profdc9/QRPAmplifier/README.md

This is a layout of the WA2EBY amplifier, improved with an added overcurrent circuit protection for the PA transistors.  It is licensed under CC-BY-SA 4.0 by Daniel Marks KW4TI
