profdc9/QRPAmplifier/BiggerPA/PA-board.png

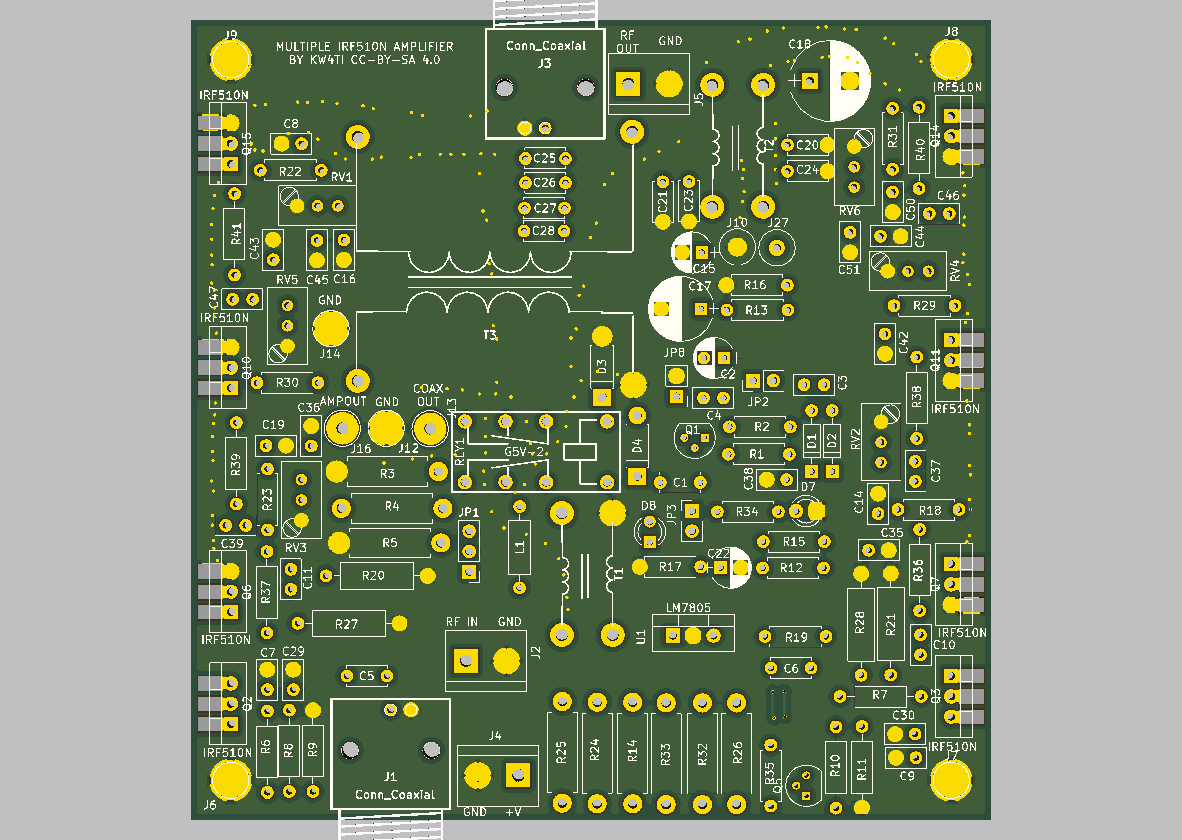
BiggerPA/PA-board.png
