profdc9/QRPAmplifier/Filter/Filter.png

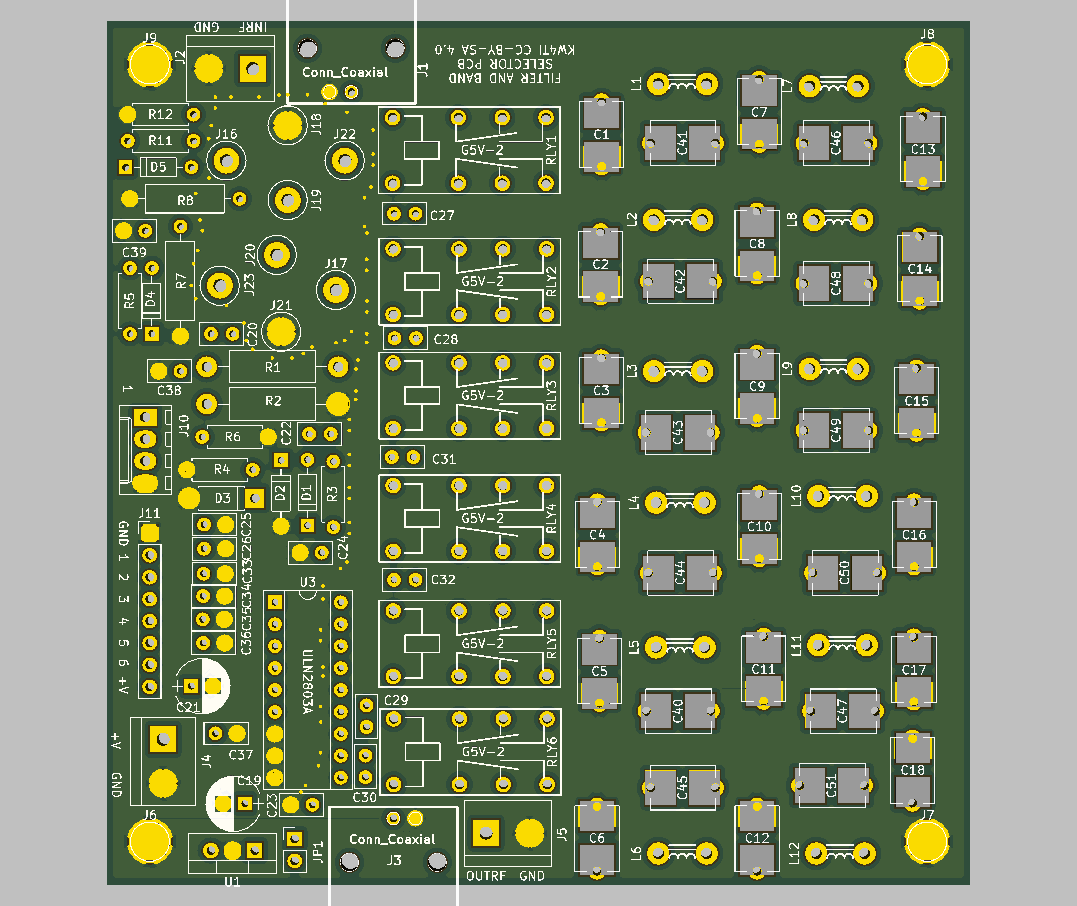
Filter/Filter.png
