profdc9/QRPAmplifier/PA/PA-board.png

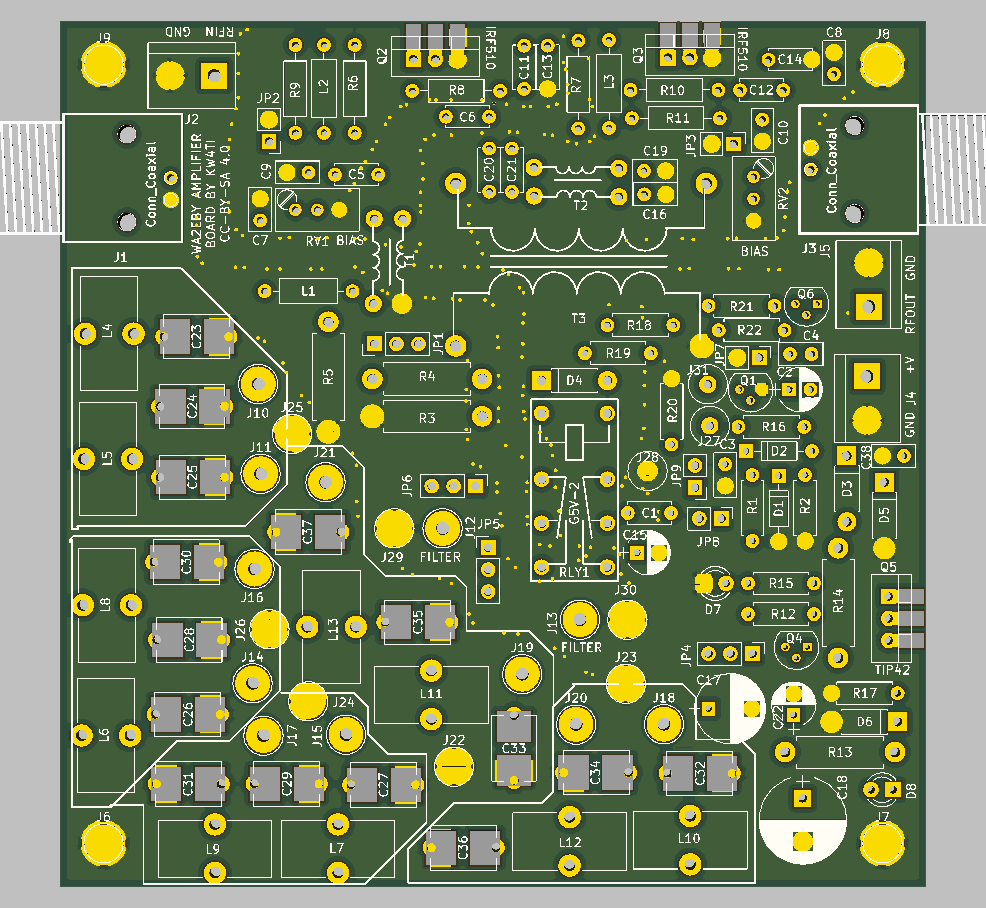
PA/PA-board.png
