profdc9/QRPAmplifier/Filter/Filter-schematic.pdf

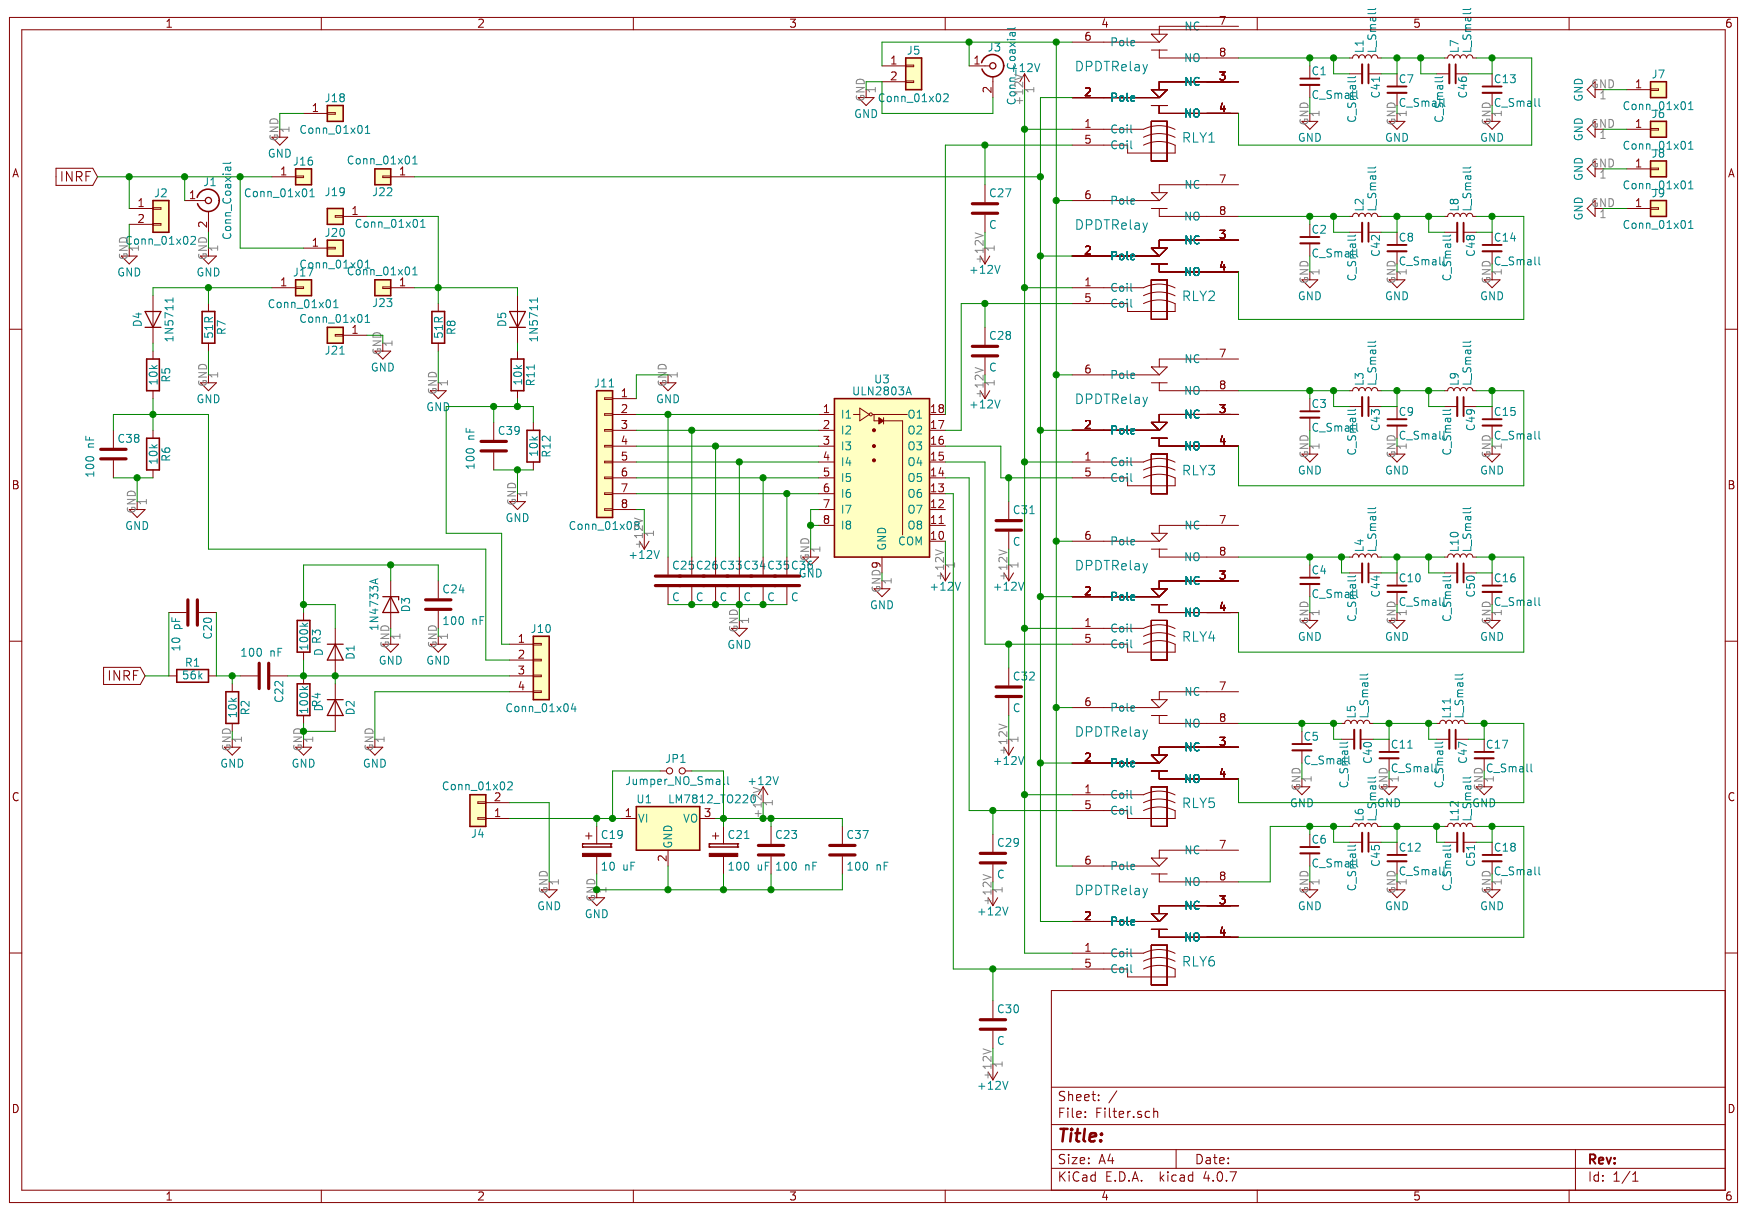
[picture p4: page 1]
