profdc9/QRPAmplifier/BiggerPA/PA-schematic.pdf

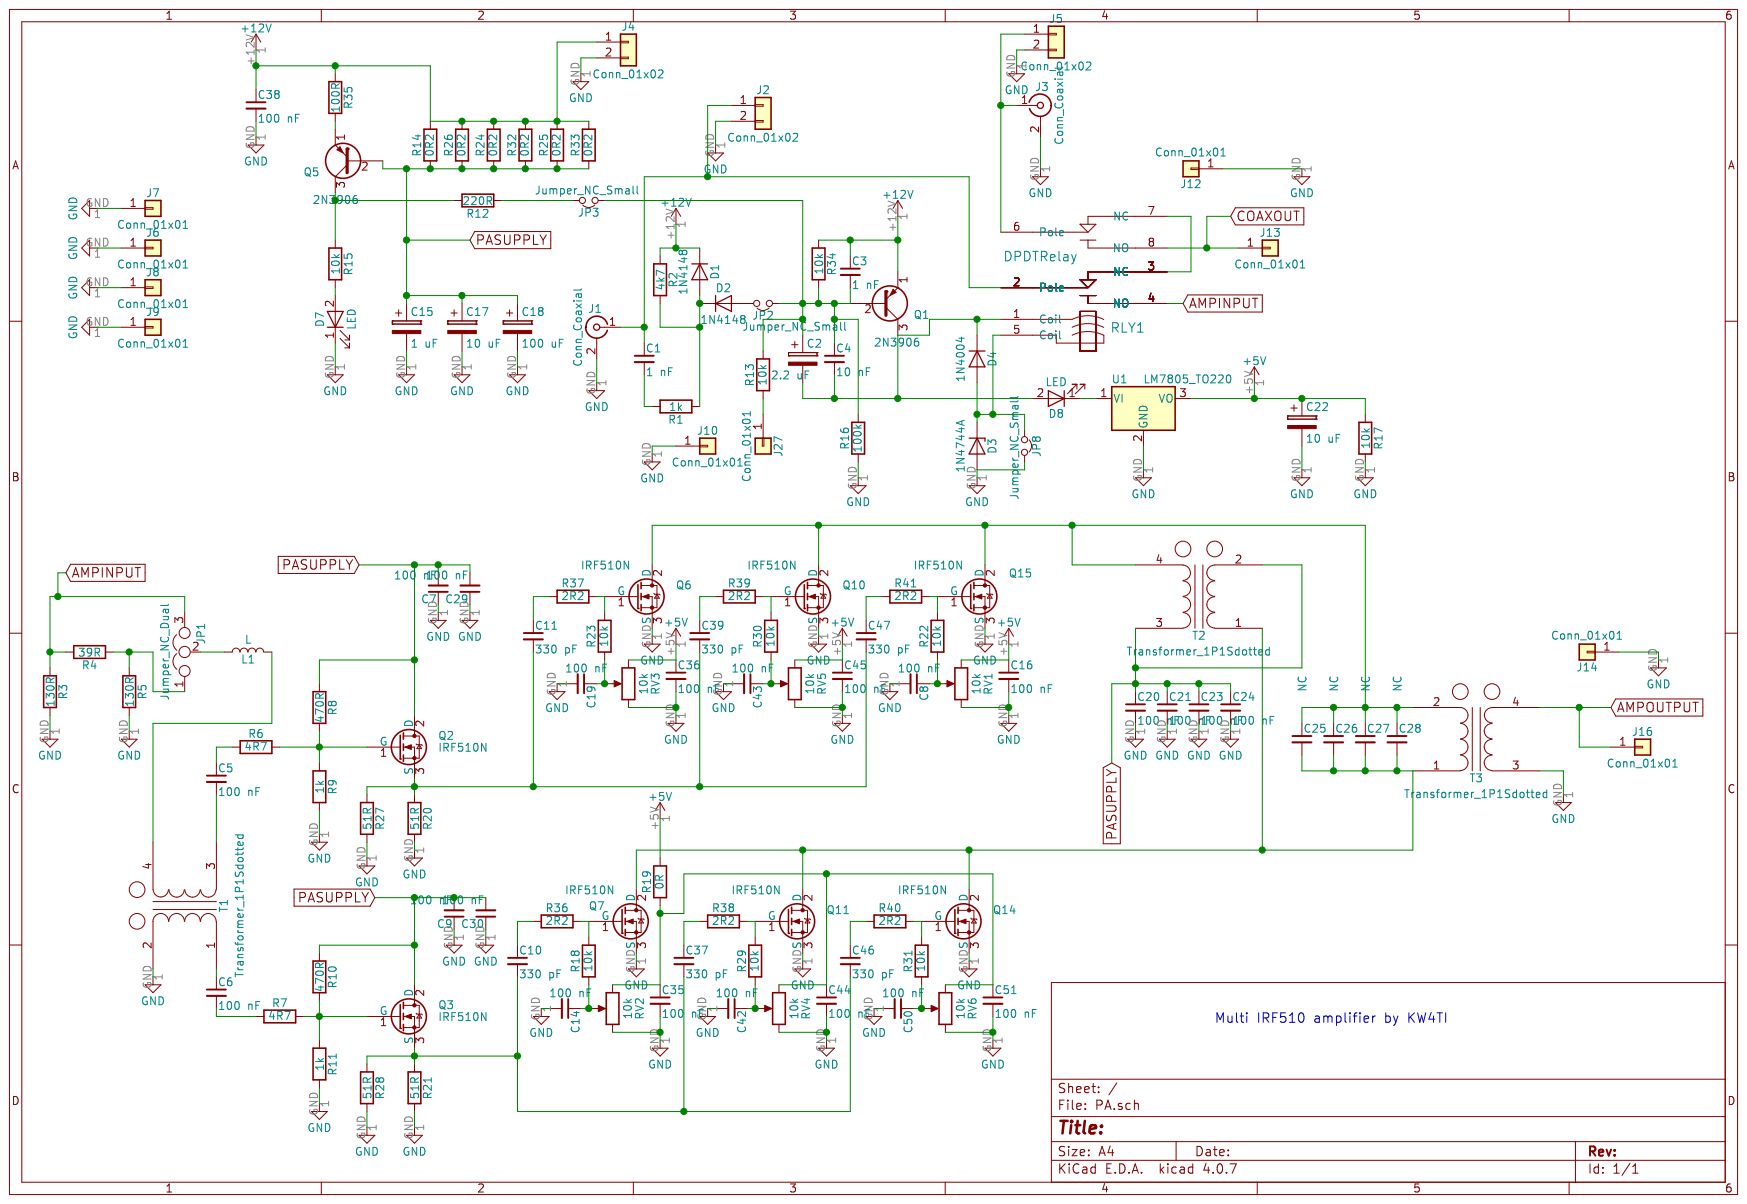
[picture p5: page 1]
