profdc9/QRPAmplifier/PA/PA-schematic.pdf

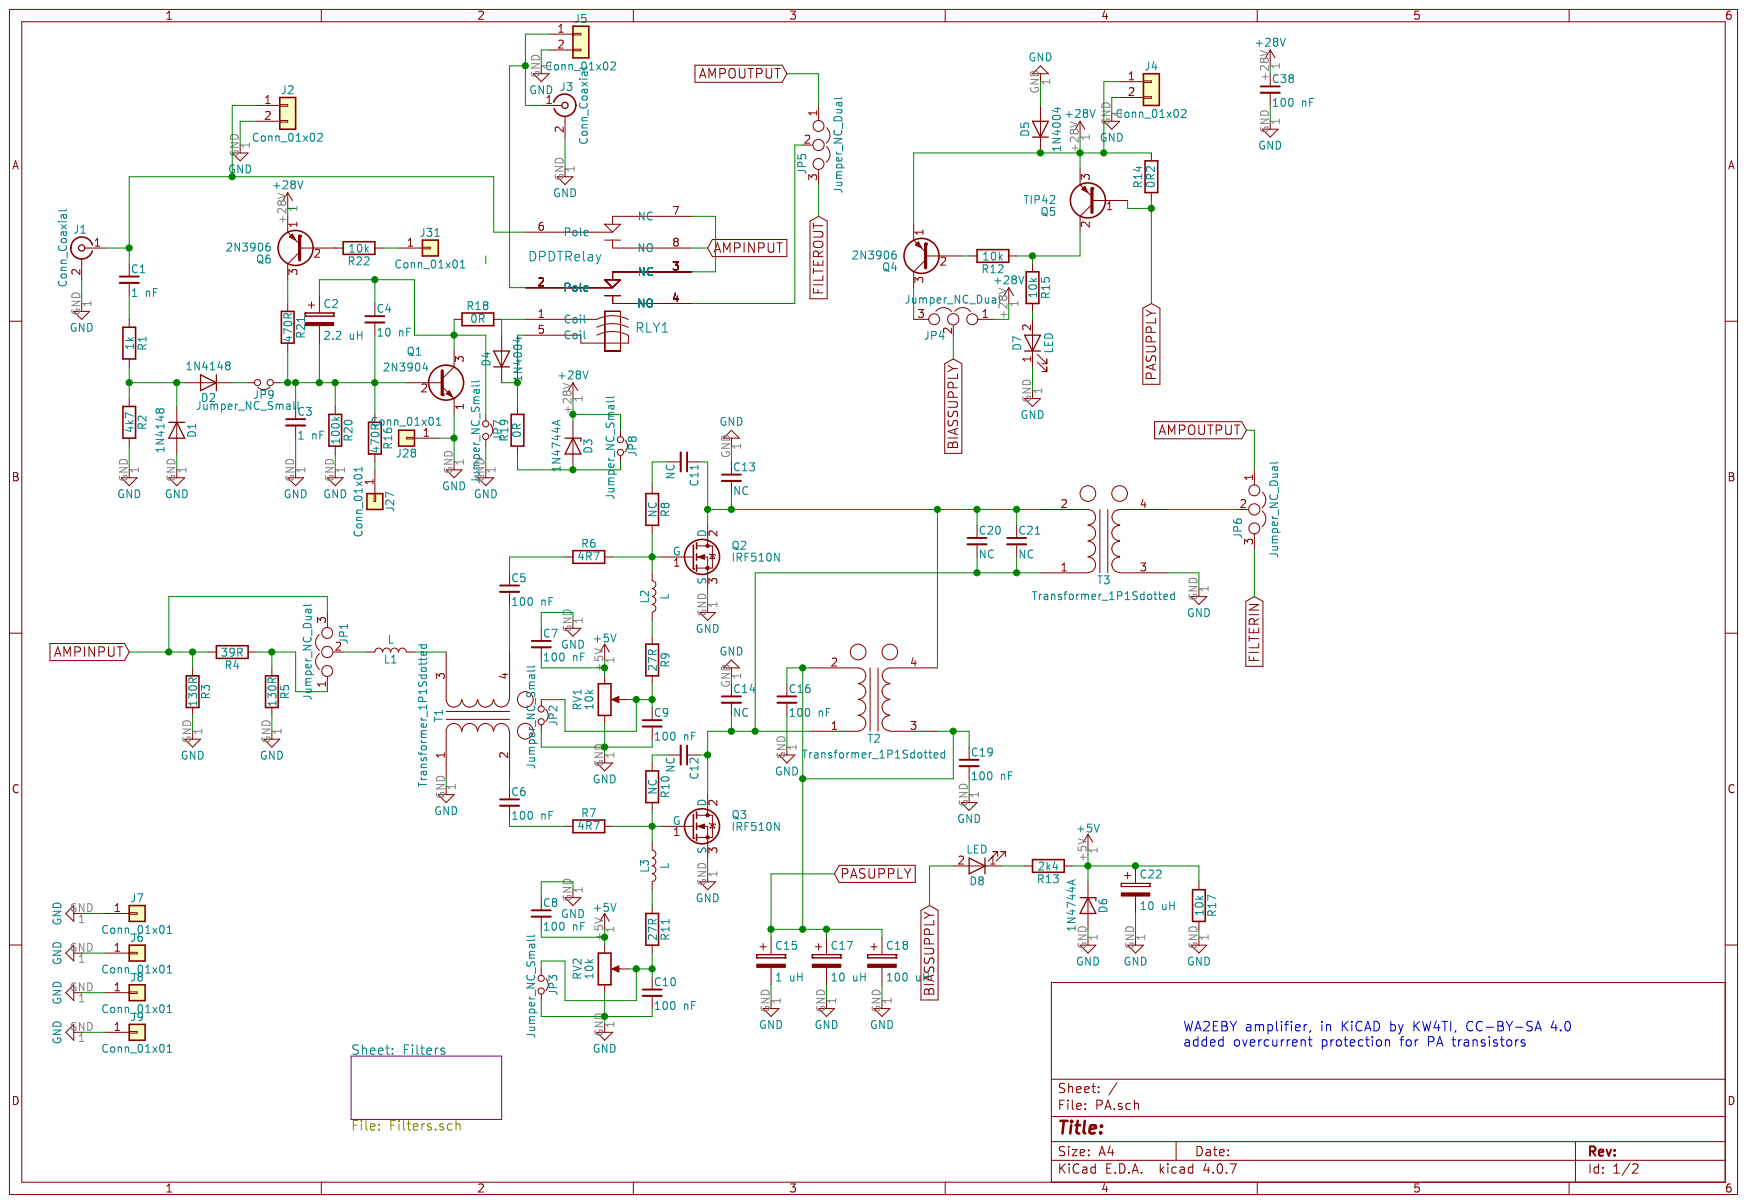
[picture p6: page 1]

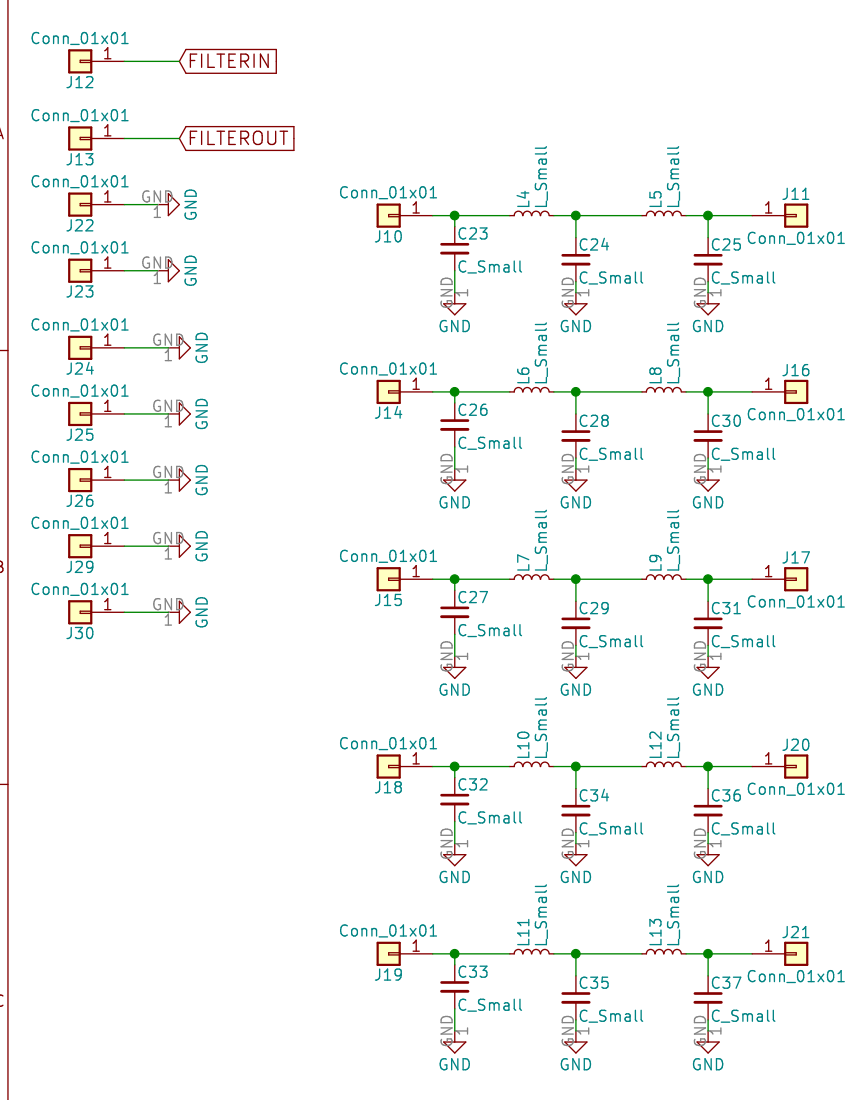
[picture p7: page 2]
