profdc9/QRPAmplifier/BiggerPA/PA.kicad_pcb

## KiCad design BiggerPA/PA.kicad_pcb (2020-04-29)

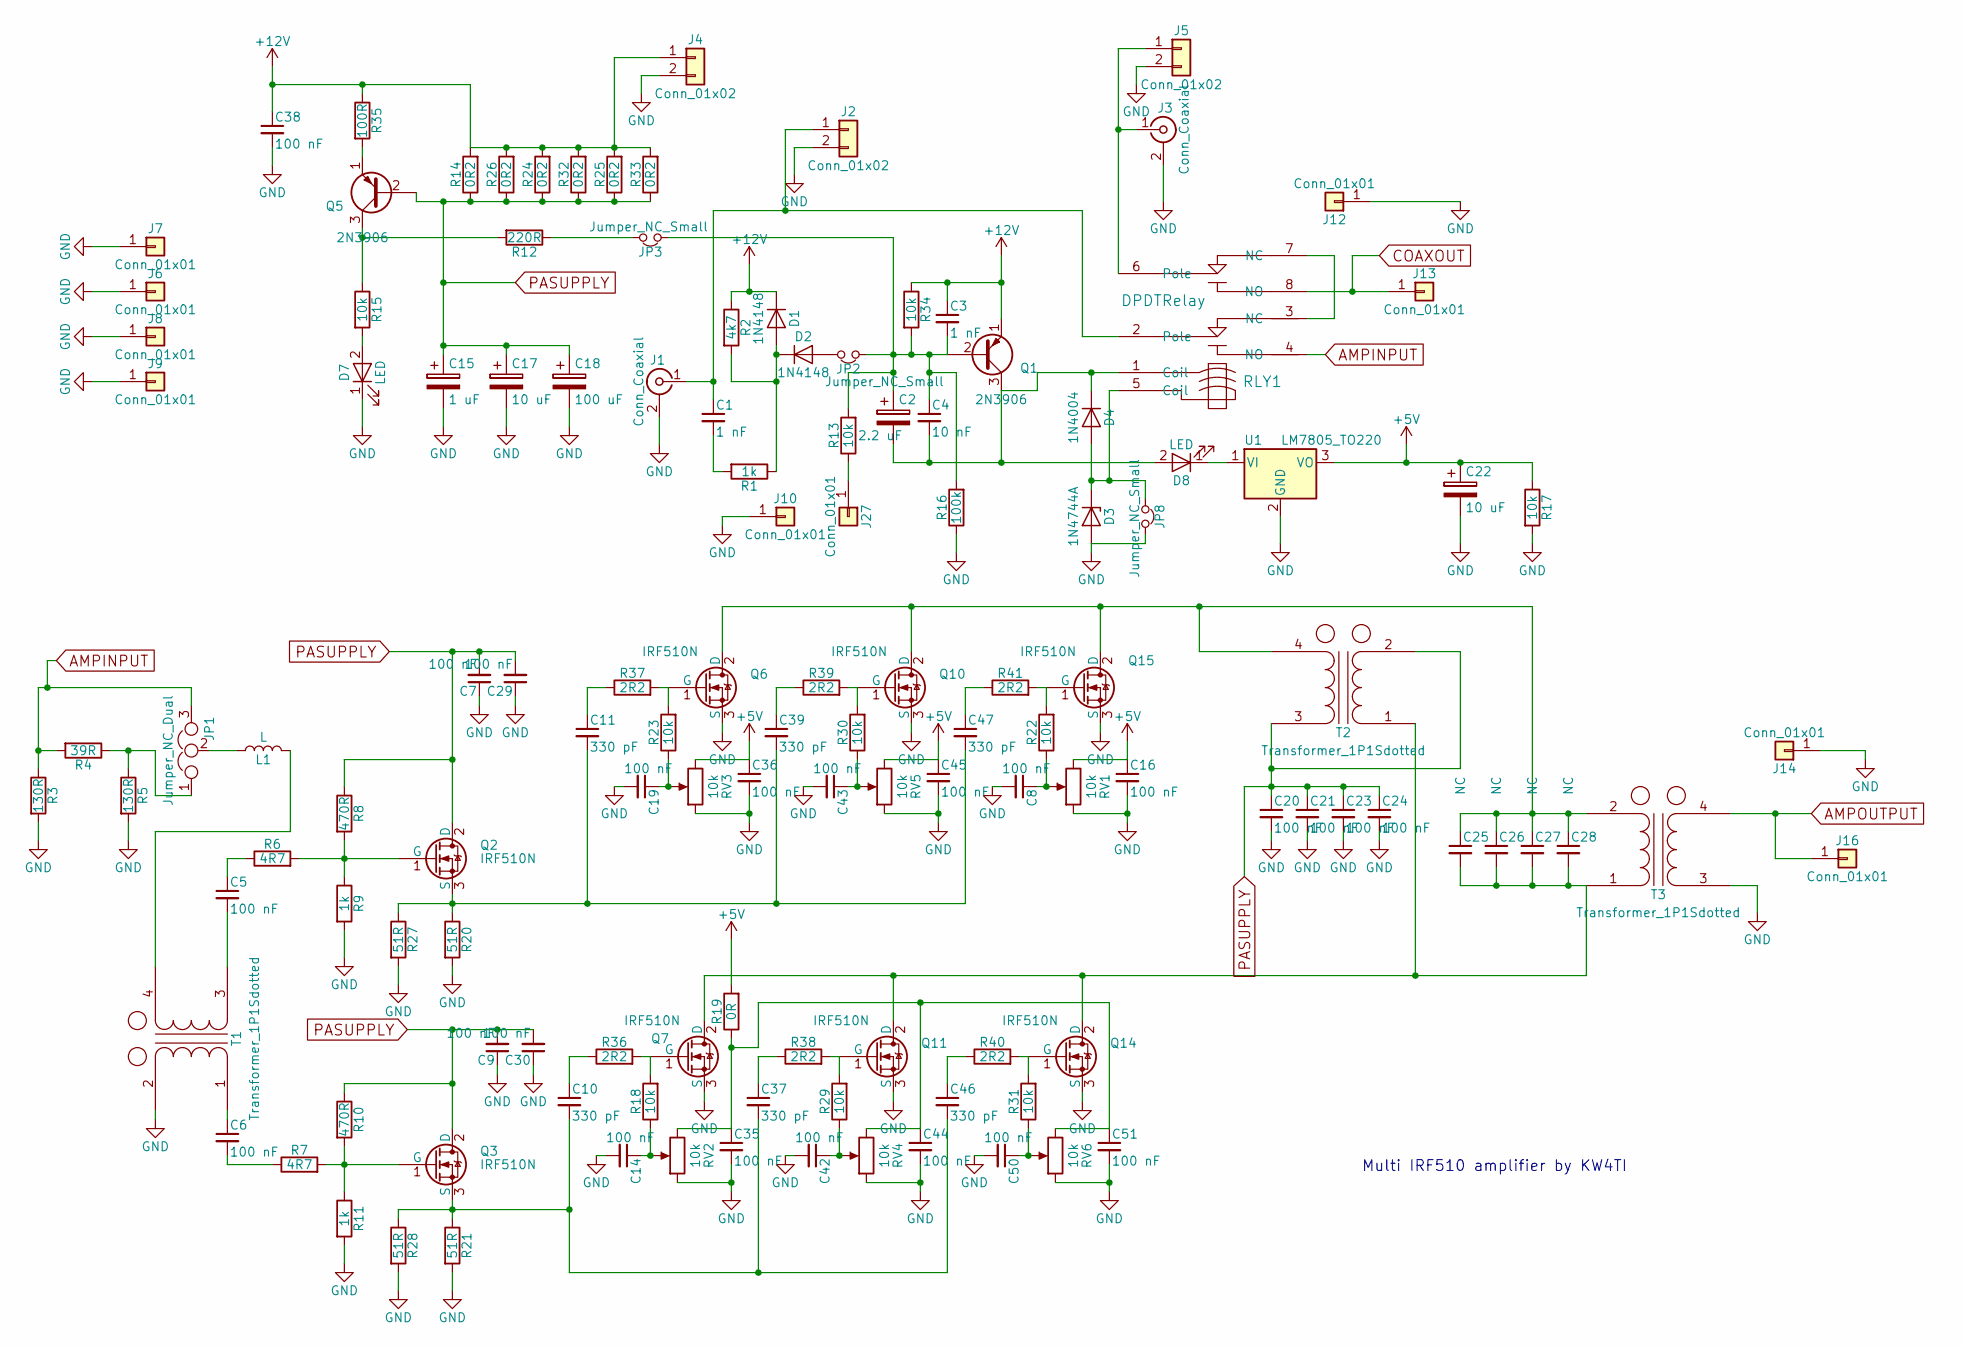
[picture p8: schematic PA.sch]

Parts:
C1: 1 nF; C_Disc_D5.0mm_W2.5mm_P5.00mm
C2: 2.2 uF; CP_Radial_D5.0mm_P2.50mm
C3: 1 nF; C_Disc_D5.0mm_W2.5mm_P2.50mm
C4: 10 nF; C_Disc_D5.0mm_W2.5mm_P2.50mm
C5, C6, C20, C21, C23, C24: 100 nF; C_Disc_D5.0mm_W2.5mm_P5.00mm
C7, C8, C9, C14, C16, C19, C29, C30, C35, C36, C38, C42, C43, C44, C45, C50, C51: 100 nF; C_Disc_D5.0mm_W2.5mm_P2.50mm
C10, C11, C37, C39, C46, C47: 330 pF; C_Disc_D5.0mm_W2.5mm_P2.50mm
C15: 1 uF; CP_Radial_D5.0mm_P2.50mm
C17: 10 uF; CP_Radial_D8.0mm_P5.00mm
C18: 100 uF; CP_Radial_D10.0mm_P5.00mm
C22: 10 uF; CP_Radial_D5.0mm_P2.50mm
C25, C26, C27, C28: NC; C_Disc_D5.0mm_W2.5mm_P5.00mm
D1, D2: 1N4148; D_DO-35_SOD27_P7.62mm_Horizontal
D3: 1N4744A; D_DO-41_SOD81_P7.62mm_Horizontal
D4: 1N4004; D_DO-41_SOD81_P7.62mm_Horizontal
D7, D8: LED; LED_D3.0mm
J1, J3: Conn_Coaxial; bnc_90_1-1337543-0
J2, J4, J5: Conn_01x02; TerminalBlock_bornier-2_P5.08mm
J6, J7, J8, J9, J10, J12, J13, J14, J16, J27: Conn_01x01; 1pin
JP1: Jumper_NC_Dual; Pin_Header_Straight_1x03_Pitch2.54mm
JP2, JP3, JP8: Jumper_NC_Small; Pin_Header_Straight_1x02_Pitch2.54mm
L1: L; L_Axial_L6.6mm_D2.7mm_P10.16mm_Horizontal_Vishay_IM-2
Q1, Q5: 2N3906; TO-92_Molded_Narrow
Q2, Q3, Q6, Q7, Q10, Q11, Q14, Q15: IRF510N; TO-220-3_Vertical_WithPads
R1: 1k; R_Axial_DIN0207_L6.3mm_D2.5mm_P7.62mm_Horizontal
R2: 4k7; R_Axial_DIN0207_L6.3mm_D2.5mm_P7.62mm_Horizontal
R3, R5: 130R; R_Axial_DIN0411_L9.9mm_D3.6mm_P12.70mm_Horizontal
R4: 39R; R_Axial_DIN0411_L9.9mm_D3.6mm_P12.70mm_Horizontal
R6, R7: 4R7; R_Axial_DIN0207_L6.3mm_D2.5mm_P10.16mm_Horizontal
R8, R10: 470R; R_Axial_DIN0207_L6.3mm_D2.5mm_P10.16mm_Horizontal
R9, R11: 1k; R_Axial_DIN0207_L6.3mm_D2.5mm_P10.16mm_Horizontal
R12: 220R; R_Axial_DIN0207_L6.3mm_D2.5mm_P7.62mm_Horizontal
R13, R15, R17, R18, R22, R23, R29, R30, R31, R34: 10k; R_Axial_DIN0207_L6.3mm_D2.5mm_P7.62mm_Horizontal
R14, R24, R25, R26, R32, R33: 0R2; R_Axial_DIN0411_L9.9mm_D3.6mm_P12.70mm_Horizontal
R16: 100k; R_Axial_DIN0207_L6.3mm_D2.5mm_P7.62mm_Horizontal
R19: 0R; R_Axial_DIN0207_L6.3mm_D2.5mm_P7.62mm_Horizontal
R20, R21, R27, R28: 51R; R_Axial_DIN0309_L9.0mm_D3.2mm_P12.70mm_Horizontal
R35: 100R; R_Axial_DIN0207_L6.3mm_D2.5mm_P7.62mm_Horizontal
R36, R37, R38, R39, R40, R41: 2R2; R_Axial_DIN0207_L6.3mm_D2.5mm_P10.16mm_Horizontal
RLY1: DPDTRelay; G2VRelay
RV1, RV2, RV3, RV4, RV5, RV6: 10k; Potentiometer_Trimmer_Bourns_3296W
T1, T2: Transformer_1P1Sdotted; GenericCMCL3
T3: Transformer_1P1Sdotted; GenericCMCLCP2
U1: LM7805_TO220; TO-220-3_Vertical

Connections:
+5V: C16.1, C22.1, C36.1, C45.1, R17.1, R19.2, RV1.3, RV3.3, RV5.3, U1.3 (VO)
+12V: C3.1, C38.1, D1.1 (K), J4.1, Q1.1 (E), R2.1, R14.2, R24.2, R25.2, R26.2, R32.2, R33.2, R34.1, R35.1
AMPINPUT: JP1.3, R3.1, R4.2, RLY1.4 (NO)
AMPOUTPUT: J16.1, T3.4 (SB)
COAXOUT: J13.1, RLY1.8 (NO)
GND: C7.1, C8.2, C9.1, C14.2, C15.2, C16.2, C17.2, C18.2, C19.2, C20.2, C21.2, C22.2, C23.2, C24.2, C29.1, C30.1, C35.2, C36.2, C38.2, C42.2, C43.2, C44.2, C45.2, C50.2, C51.2, D3.2 (A), D7.1 (K), J1.2 (Ext), J2.2, J3.2 (Ext), J4.2, J5.2, J6.1, J7.1, J8.1, J9.1, J10.1, J12.1, J14.1, JP8.2, Q6.3 (S), Q7.3 (S), Q10.3 (S), Q11.3 (S), Q14.3 (S), Q15.3 (S), R3.2, R5.2, R9.2, R11.2, R16.1, R17.2, R20.2, R21.2, R27.2, R28.2, RV1.1, RV2.1, RV3.1, RV4.1, RV5.1, RV6.1, T1.2 (AB), T3.3 (SA), U1.2 (GND)
unnamed: C1.1, J1.1 (In), J2.1, RLY1.2 (Pole)
unnamed: C1.2, R1.2
unnamed: C2.1, C3.2, C4.1, JP2.1, JP3.1, Q1.2 (B), R13.2, R16.2, R34.2
unnamed: C2.2, C4.2, D4.1 (K), D8.2 (A), Q1.3 (C), RLY1.1 (Coil)
unnamed: C5.1, R6.1
unnamed: C5.2, T1.3 (SA)
unnamed: C6.1, T1.1 (AA)
unnamed: C6.2, R7.1
unnamed: C8.1, R22.1, RV1.2
unnamed: C10.1, R36.1
unnamed: C10.2, C37.2, C46.2, Q3.3 (S), R21.1, R28.1
unnamed: C11.1, R37.1
unnamed: C11.2, C39.2, C47.2, Q2.3 (S), R20.1, R27.1
unnamed: C14.1, R18.1, RV2.2
unnamed: C19.1, R23.1, RV3.2
unnamed: C25.1, C26.1, C27.1, C28.1, Q6.2 (D), Q10.2 (D), Q15.2 (D), T2.4 (SB), T3.2 (AB)
unnamed: C25.2, C26.2, C27.2, C28.2, Q7.2 (D), Q11.2 (D), Q14.2 (D), T2.1 (AA), T3.1 (AA)
unnamed: C35.1, C44.1, C51.1, R19.1, RV2.3, RV4.3, RV6.3
unnamed: C37.1, R38.1
unnamed: C39.1, R39.1
unnamed: C42.1, R29.1, RV4.2
unnamed: C43.1, R30.1, RV5.2
unnamed: C46.1, R40.1
unnamed: C47.1, R41.1
unnamed: C50.1, R31.1, RV6.2
unnamed: D1.2 (A), D2.1 (K), R1.1, R2.2
unnamed: D2.2 (A), JP2.2
unnamed: D3.1 (K), D4.2 (A), JP8.1, RLY1.5 (Coil)
unnamed: D7.2 (A), R15.2
unnamed: D8.1 (K), U1.1 (VI)
unnamed: J3.1 (In), J5.1, RLY1.6 (Pole)
unnamed: J27.1, R13.1
unnamed: JP1.1, R4.1, R5.1
unnamed: JP1.2, L1.1
unnamed: JP3.2, R12.1
unnamed: L1.2, T1.4 (SB)
unnamed: Q2.1 (G), R6.2, R8.2, R9.1
unnamed: Q3.1 (G), R7.2, R10.2, R11.1
unnamed: Q5.1 (E), R35.2
unnamed: Q5.3 (C), R12.2, R15.1
unnamed: Q6.1 (G), R23.2, R37.2
unnamed: Q7.1 (G), R18.2, R36.2
unnamed: Q10.1 (G), R30.2, R39.2
unnamed: Q11.1 (G), R29.2, R38.2
unnamed: Q14.1 (G), R31.2, R40.2
unnamed: Q15.1 (G), R22.2, R41.2
unnamed: RLY1.3 (NC), RLY1.7 (NC)
PASUPPLY: C7.2, C9.2, C15.1, C17.1, C18.1, C20.1, C21.1, C23.1, C24.1, C29.2, C30.2, Q2.2 (D), Q3.2 (D), Q5.2 (B), R8.1, R10.1, R14.1, R24.1, R25.1, R26.1, R32.1, R33.1, T2.2 (AB), T2.3 (SA)

Notes on the sheet:
Multi IRF510 amplifier by KW4TI

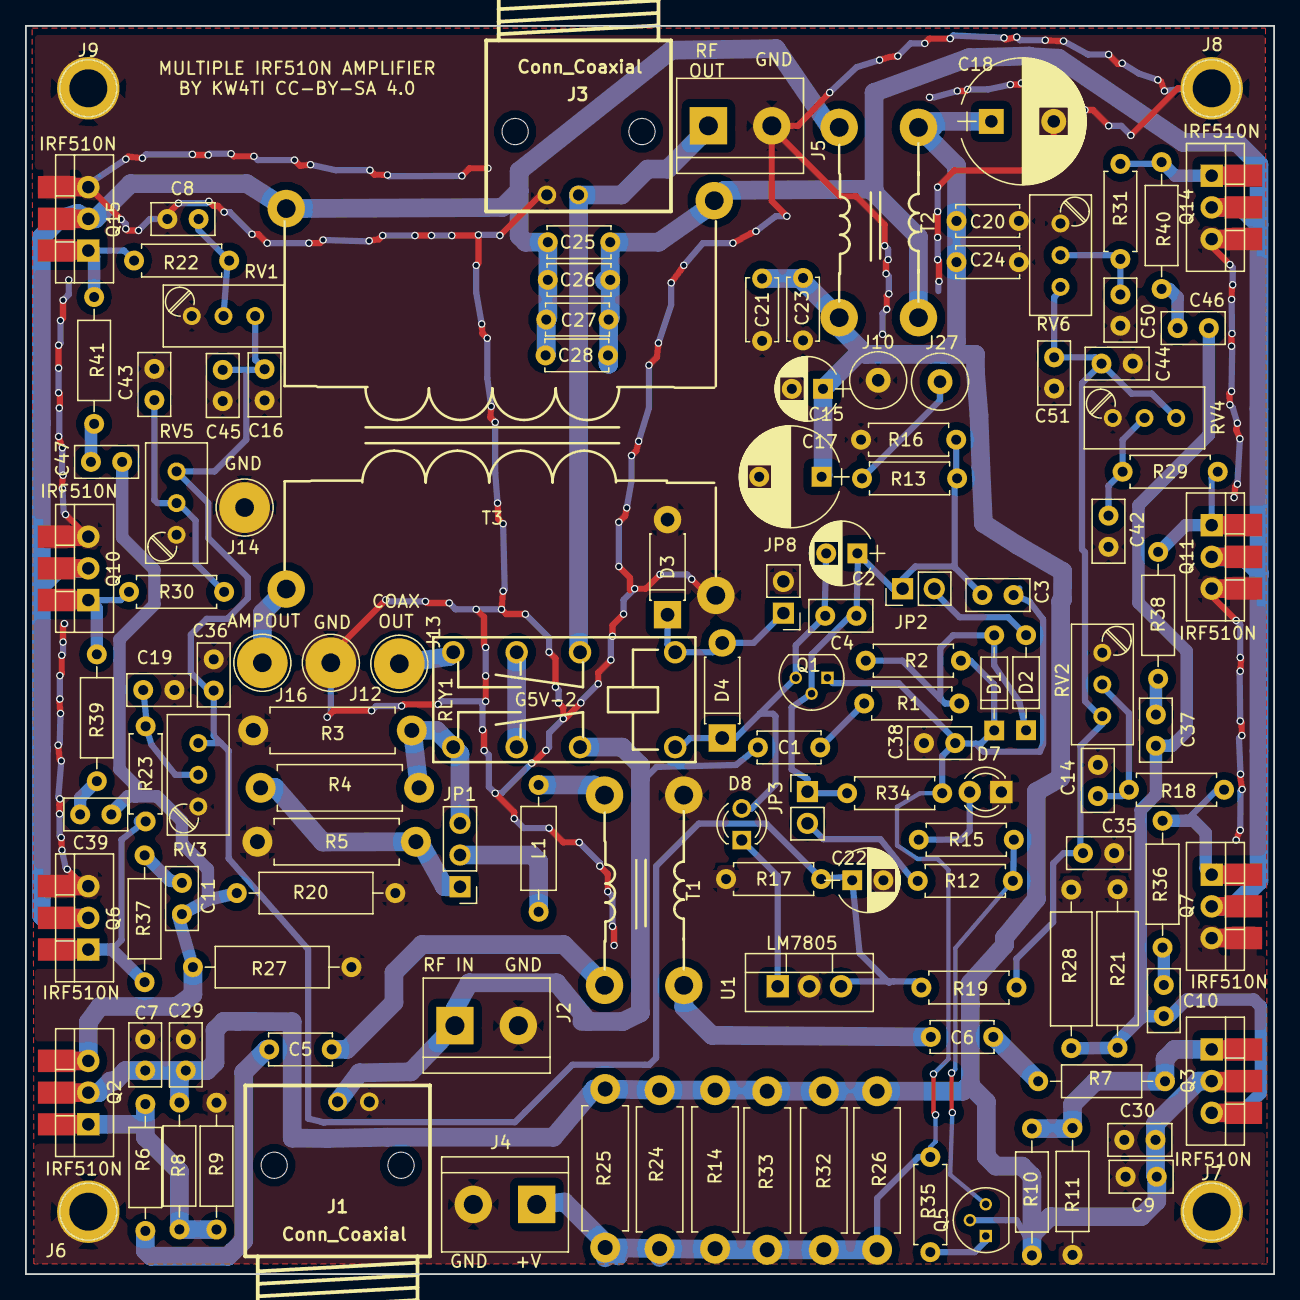
[picture p9: board BiggerPA/PA.kicad_pcb from above]

Board: 2 copper layers, 100.0 x 100.0 mm, 129 parts (0 on the bottom side), 54 nets.
