profdc9/QRPAmplifier/Filter/Filter.kicad_pcb

## KiCad design Filter/Filter.kicad_pcb (2020-04-29)

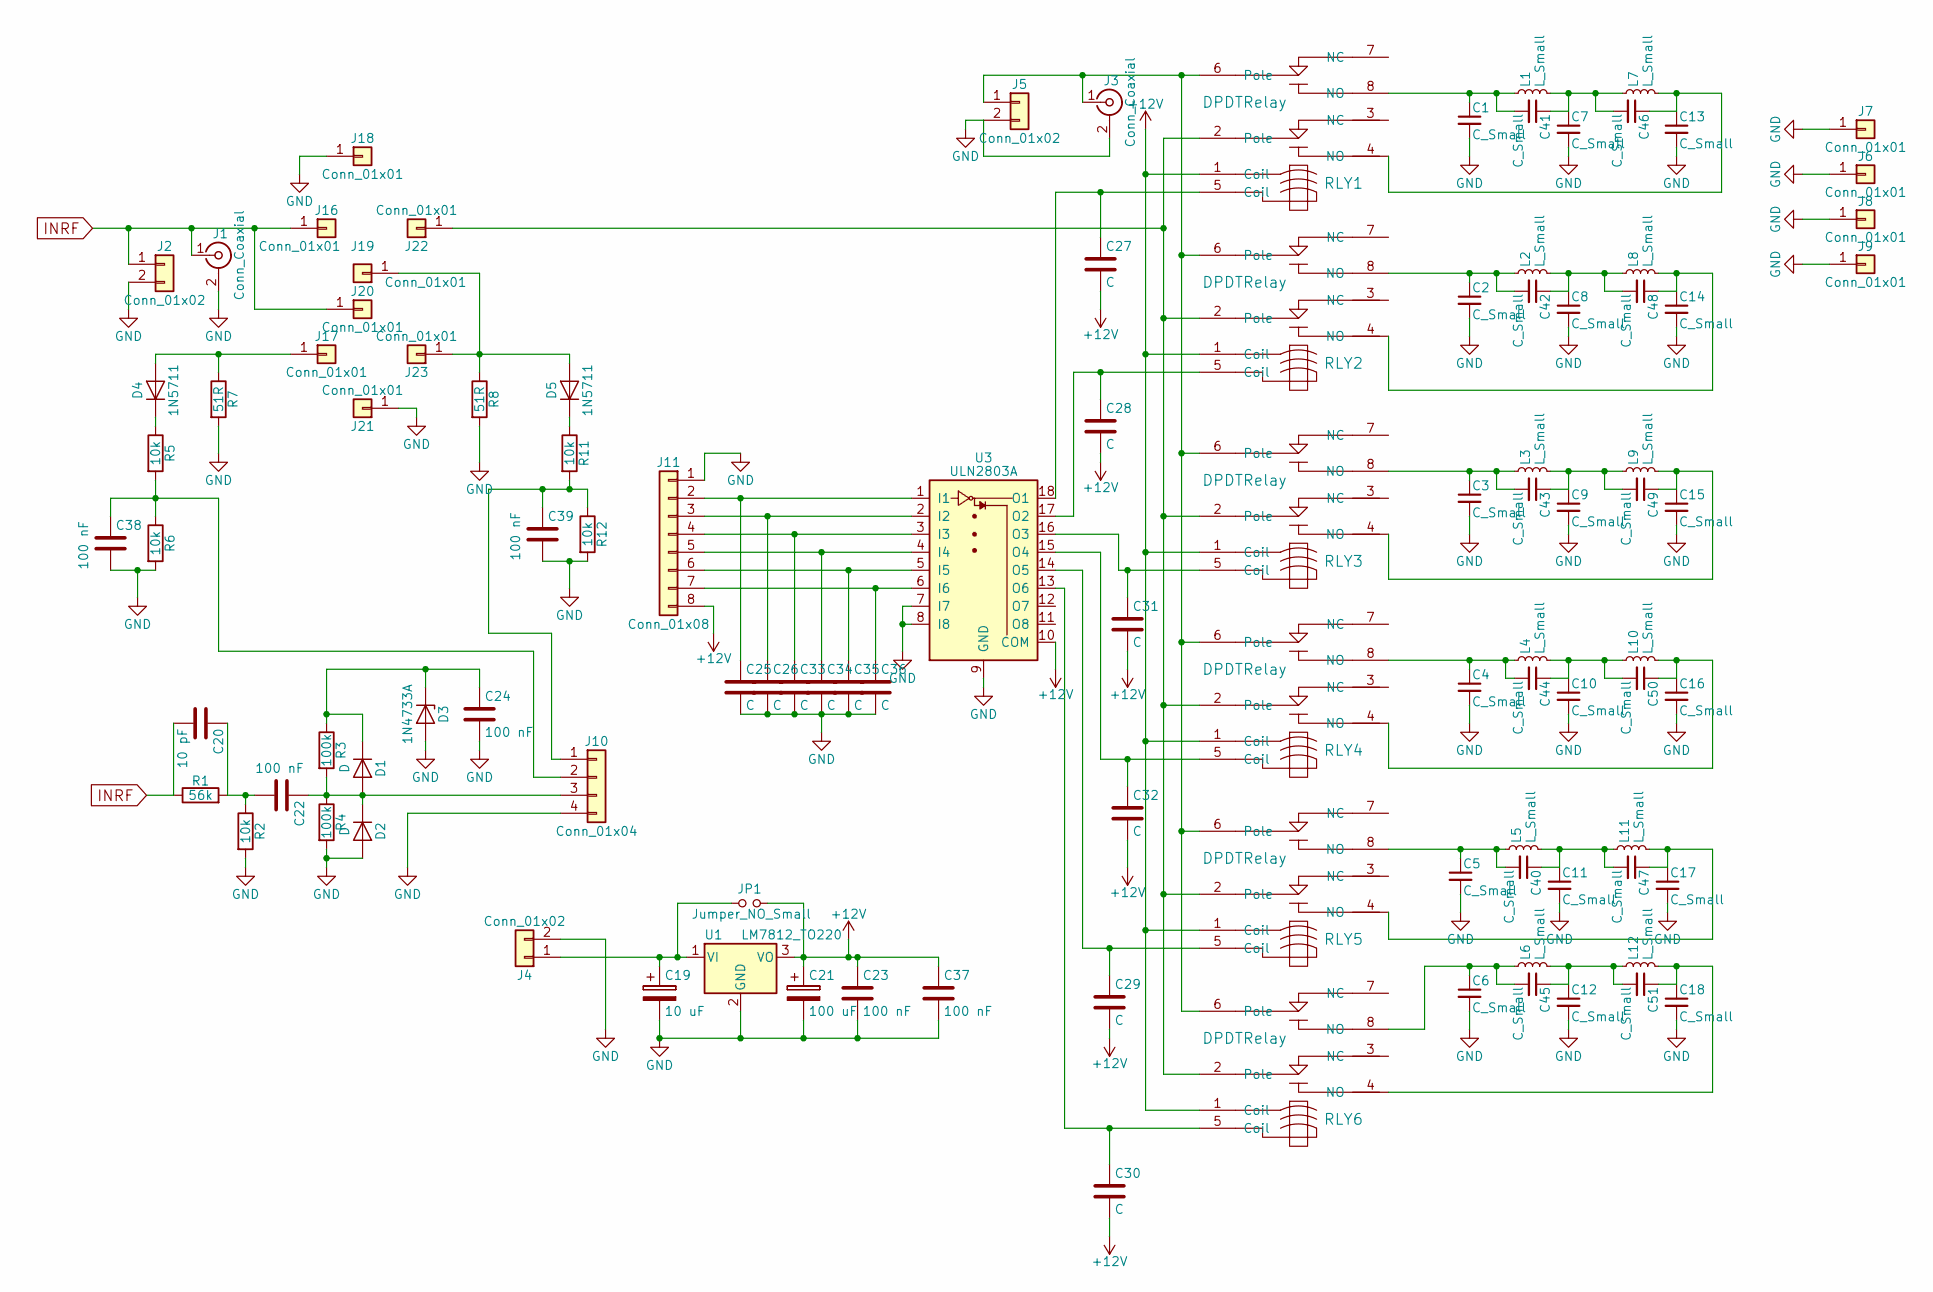
[picture p10: schematic Filter.sch]

Parts:
C1, C2, C3, C4, C5, C6, C7, C8, C9, C10, C11, C12, C13, C14, C15, C16, C17, C18, C40, C41, C42, C43, C44, C45, C46, C47, C48, C49, C50, C51: C_Small; C_Disc_SMD
C19: 10 uF; CP_Radial_D6.3mm_P2.50mm
C20: 10 pF; C_Disc_D5.0mm_W2.5mm_P2.50mm
C21: 100 uF; CP_Radial_D6.3mm_P2.50mm
C22, C23, C24, C37, C38, C39: 100 nF; C_Disc_D5.0mm_W2.5mm_P2.50mm
C25, C26, C27, C28, C29, C30, C31, C32, C33, C34, C35, C36: C; C_Disc_D5.0mm_W2.5mm_P2.50mm
D1, D2: D; D_DO-35_SOD27_P7.62mm_Horizontal
D3: 1N4733A; D_DO-41_SOD81_P7.62mm_Horizontal
D4, D5: 1N5711; D_DO-35_SOD27_P7.62mm_Horizontal
J1, J3: Conn_Coaxial; bnc_90_1-1337543-0
J2, J4, J5: Conn_01x02; TerminalBlock_bornier-2_P5.08mm
J6, J7, J8, J9, J16, J17, J18, J19, J20, J21, J22, J23: Conn_01x01; 1pin
J10: Conn_01x04; Molex_KK-6410-04_04x2.54mm_Straight
J11: Conn_01x08; Pin_Header_Straight_1x08_Pitch2.54mm
JP1: Jumper_NO_Small; Pin_Header_Straight_1x02_Pitch2.54mm
L1, L2, L3, L4, L5, L6, L7, L8, L9, L10, L11, L12: L_Small; L_Toroid_Vertical_L13.0mm_W6.5mm_P5.60mm_mod
R1: 56k; R_Axial_DIN0411_L9.9mm_D3.6mm_P15.24mm_Horizontal
R2: 10k; R_Axial_DIN0411_L9.9mm_D3.6mm_P15.24mm_Horizontal
R3, R4: 100k; R_Axial_DIN0207_L6.3mm_D2.5mm_P7.62mm_Horizontal
R5, R6, R11, R12: 10k; R_Axial_DIN0207_L6.3mm_D2.5mm_P7.62mm_Horizontal
R7, R8: 51R; R_Axial_DIN0309_L9.0mm_D3.2mm_P12.70mm_Horizontal
RLY1, RLY2, RLY3, RLY4, RLY5, RLY6: DPDTRelay; G2VRelay
U1: LM7812_TO220; TO-220-3_Vertical
U3: ULN2803A; DIP-18_W7.62mm_Socket

Connections:
+12V: C21.1, C23.1, C27.2, C28.2, C29.2, C30.2, C31.2, C32.2, C37.1, J11.8, JP1.2, RLY1.1 (Coil), RLY2.1 (Coil), RLY3.1 (Coil), RLY4.1 (Coil), RLY5.1 (Coil), RLY6.1 (Coil), U1.3 (VO), U3.10 (COM)
GND: C1.2, C2.2, C3.2, C4.2, C5.2, C6.2, C7.2, C8.2, C9.2, C10.2, C11.2, C12.2, C13.2, C14.2, C15.2, C16.2, C17.2, C18.2, C19.2, C21.2, C23.2, C24.2, C25.2, C26.2, C33.2, C34.2, C35.2, C36.2, C37.2, C38.2, C39.2, D2.2 (A), D3.2 (A), J1.2 (Ext), J2.2, J3.2 (Ext), J4.2, J5.2, J6.1, J7.1, J8.1, J9.1, J10.4, J11.1, J18.1, J21.1, R2.2, R4.2, R6.2, R7.2, R8.2, R12.2, U1.2 (GND), U3.7 (I7), U3.8 (I8), U3.9 (GND)
INRF: C20.2, J1.1 (In), J2.1, J16.1, J20.1, R1.1
unnamed: C1.1, C41.2, L1.1, RLY1.8 (NO)
unnamed: C2.1, C42.2, L2.1, RLY2.8 (NO)
unnamed: C3.1, C43.2, L3.1, RLY3.8 (NO)
unnamed: C4.1, C44.2, L4.1, RLY4.8 (NO)
unnamed: C10.1, C44.1, C50.2, L4.2, L10.1
unnamed: C11.1, C40.1, C47.2, L5.2, L11.1
unnamed: C12.1, C45.1, C51.2, L6.2, L12.1
unnamed: C13.1, C46.1, L7.2, RLY1.4 (NO)
unnamed: C14.1, C48.1, L8.2, RLY2.4 (NO)
unnamed: C15.1, C49.1, L9.2, RLY3.4 (NO)
unnamed: C16.1, C50.1, L10.2, RLY4.4 (NO)
unnamed: C17.1, C47.1, L11.2, RLY5.4 (NO)
unnamed: C18.1, C51.1, L12.2, RLY6.4 (NO)
unnamed: C19.1, J4.1, JP1.1, U1.1 (VI)
unnamed: C20.1, C22.2, R1.2, R2.1
unnamed: C22.1, D1.2 (A), D2.1 (K), J10.3, R3.2, R4.1
unnamed: C24.1, D1.1 (K), D3.1 (K), R3.1
unnamed: C25.1, J11.2, U3.1 (I1)
unnamed: C26.1, J11.3, U3.2 (I2)
unnamed: C27.1, RLY1.5 (Coil), U3.18 (O1)
unnamed: C28.1, RLY2.5 (Coil), U3.17 (O2)
unnamed: C29.1, RLY5.5 (Coil), U3.14 (O5)
unnamed: C30.1, RLY6.5 (Coil), U3.13 (O6)
unnamed: C31.1, RLY3.5 (Coil), U3.16 (O3)
unnamed: C32.1, RLY4.5 (Coil), U3.15 (O4)
unnamed: C33.1, J11.4, U3.3 (I3)
unnamed: C34.1, J11.5, U3.4 (I4)
unnamed: C35.1, J11.6, U3.5 (I5)
unnamed: C36.1, J11.7, U3.6 (I6)
unnamed: C38.1, J10.2, R5.2, R6.1
unnamed: C39.1, J10.1, R11.2, R12.1
unnamed: C5.1, C40.2, L5.1, RLY5.8 (NO)
unnamed: C7.1, C41.1, C46.2, L1.2, L7.1
unnamed: C8.1, C42.1, C48.2, L2.2, L8.1
unnamed: C9.1, C43.1, C49.2, L3.2, L9.1
unnamed: C6.1, C45.2, L6.1, RLY6.8 (NO)
unnamed: D4.1 (K), R5.1
unnamed: D4.2 (A), J17.1, R7.1
unnamed: D5.1 (K), R11.1
unnamed: D5.2 (A), J19.1, J23.1, R8.1
unnamed: J3.1 (In), J5.1, RLY1.6 (Pole), RLY2.6 (Pole), RLY3.6 (Pole), RLY4.6 (Pole), RLY5.6 (Pole), RLY6.6 (Pole)
unnamed: J22.1, RLY1.2 (Pole), RLY2.2 (Pole), RLY3.2 (Pole), RLY4.2 (Pole), RLY5.2 (Pole), RLY6.2 (Pole)

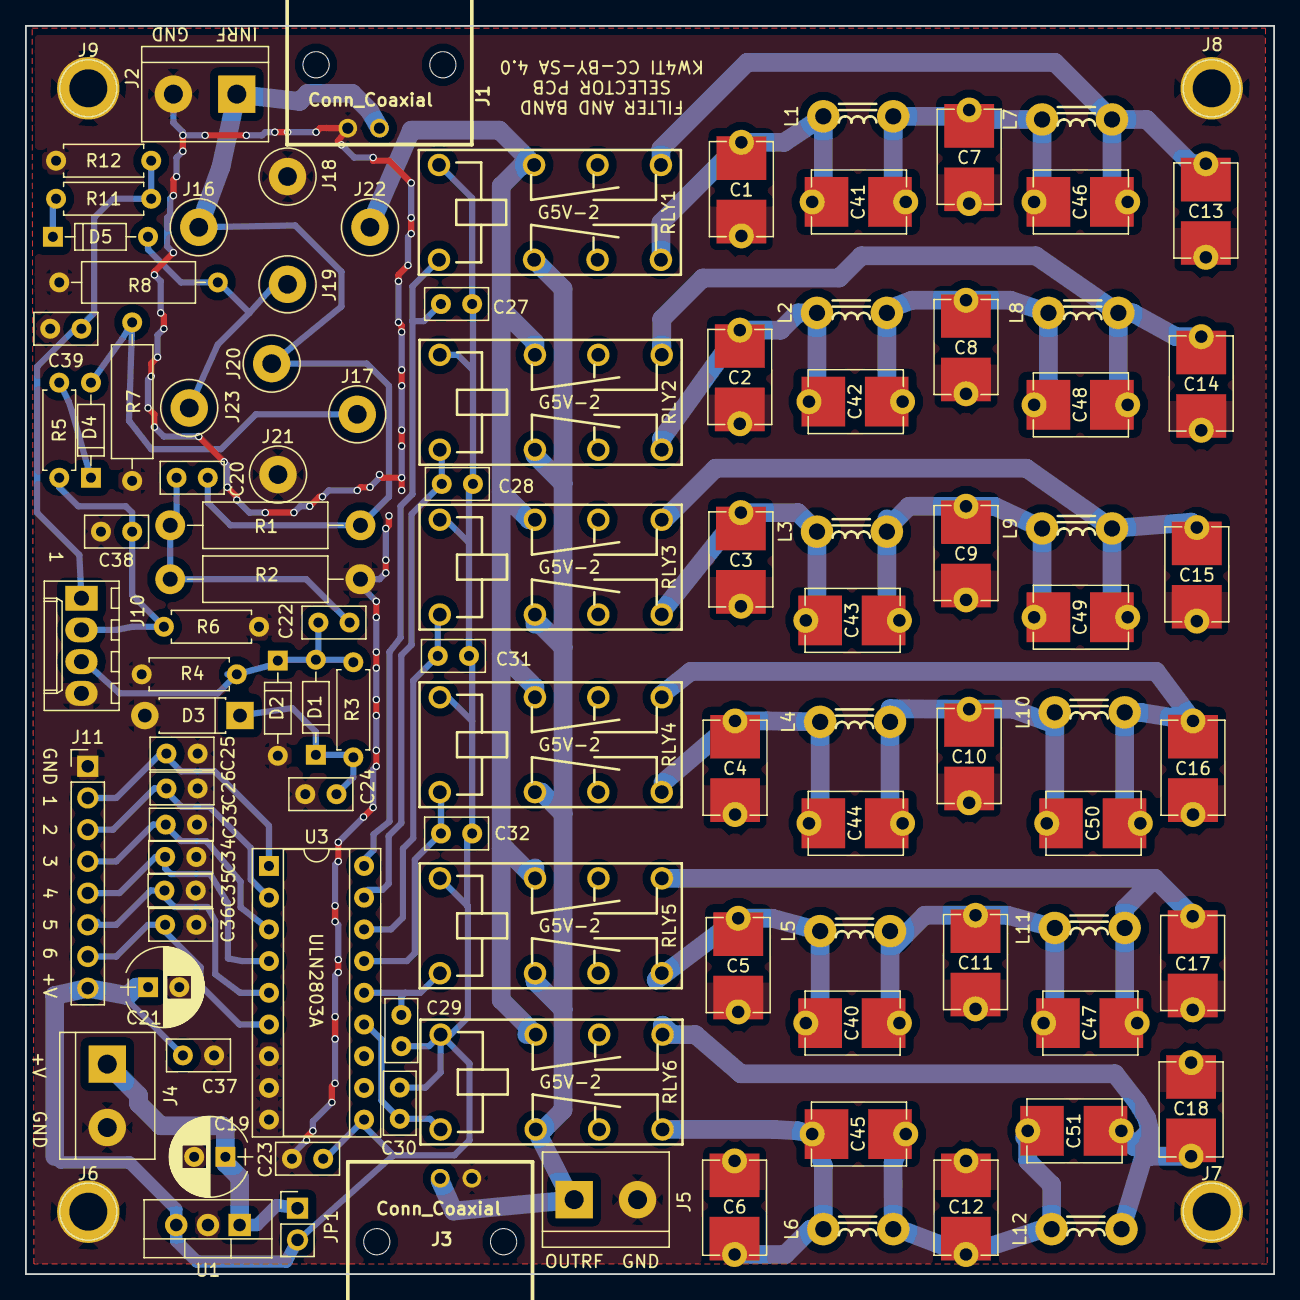
[picture p11: board Filter.kicad_pcb from above]

Board: 2 copper layers, 100.0 x 100.0 mm, 106 parts (0 on the bottom side), 45 nets.
