profdc9/QRPAmplifier/PA/PA.kicad_pcb

## KiCad design PA/PA.kicad_pcb (2019-10-20)

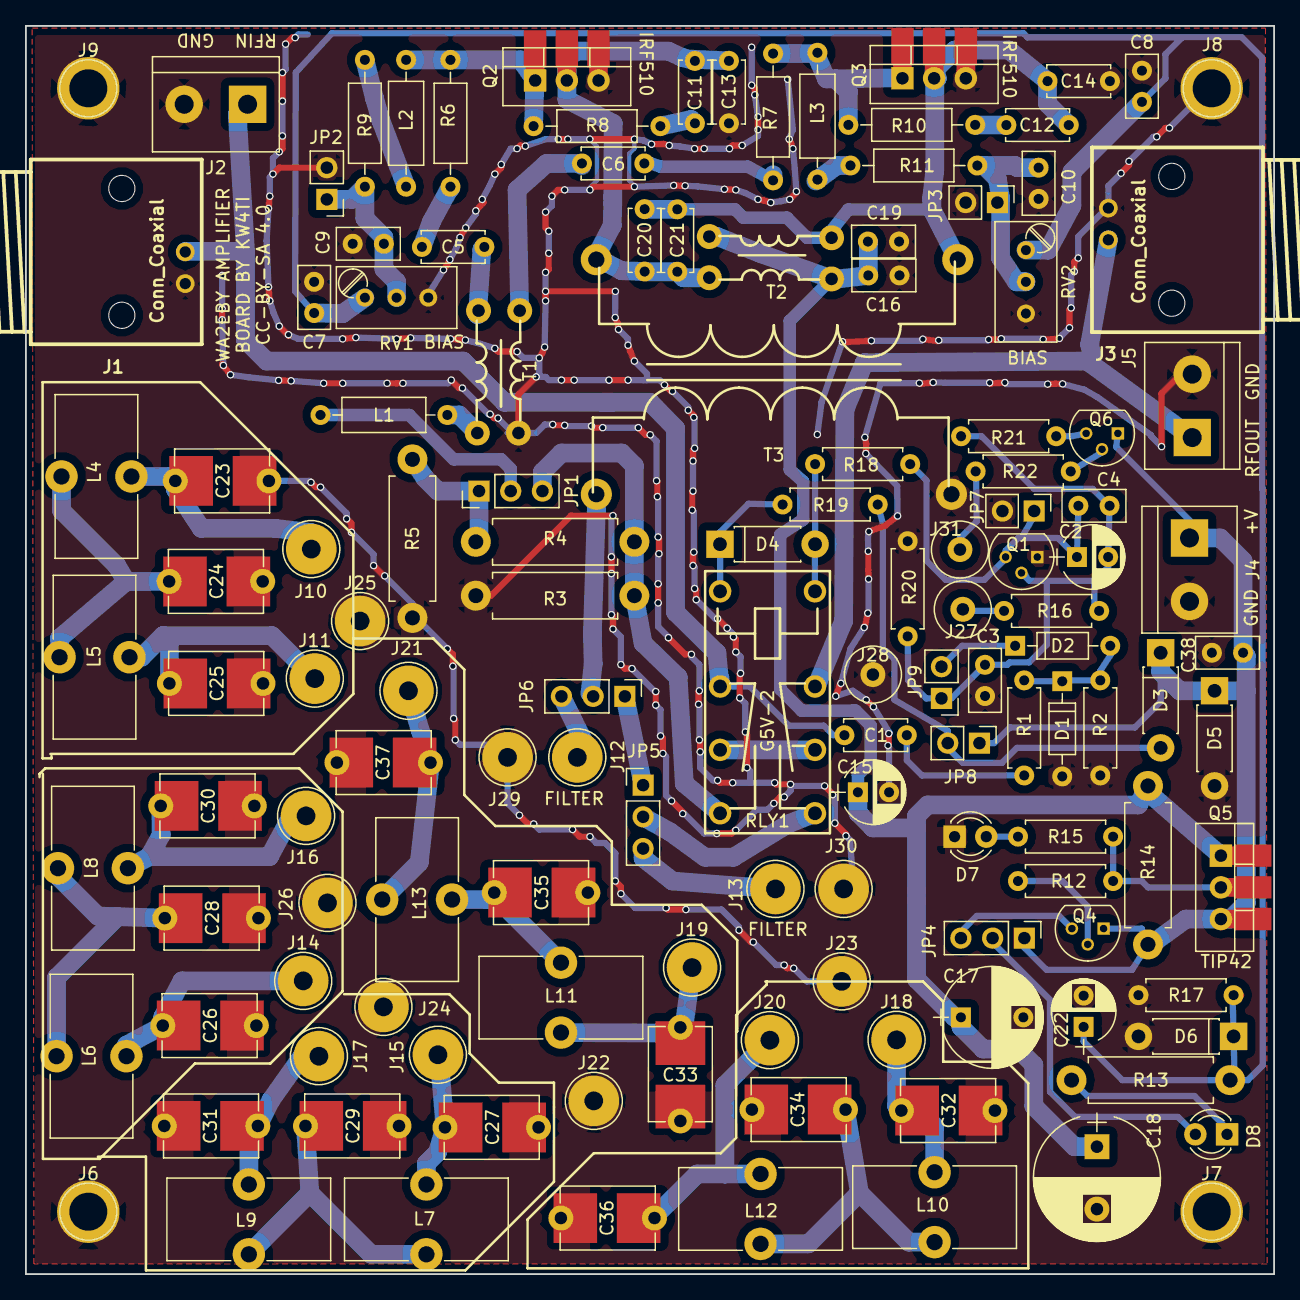
[picture p12: board PA/PA.kicad_pcb from above]

Board: 2 copper layers, 100.0 x 100.0 mm, 133 parts (0 on the bottom side), 63 nets.

Parts:
C1: 1 nF; C_Disc_D5.0mm_W2.5mm_P5.00mm
C2: 2.2 uH; CP_Radial_D5.0mm_P2.50mm
C3: 1 nF; C_Disc_D5.0mm_W2.5mm_P2.50mm
C4: 10 nF; C_Disc_D5.0mm_W2.5mm_P2.50mm
C5, C6: 100 nF; C_Disc_D5.0mm_W2.5mm_P5.00mm
C7, C8, C9, C10, C16, C19, C38: 100 nF; C_Disc_D5.0mm_W2.5mm_P2.50mm
C11, C12, C13, C14, C20, C21: NC; C_Disc_D5.0mm_W2.5mm_P5.00mm
C15: 1 uH; CP_Radial_D5.0mm_P2.50mm
C17: 10 uH; CP_Radial_D8.0mm_P5.00mm
C18: 100 uH; CP_Radial_D10.0mm_P5.00mm
C22: 10 uH; CP_Radial_D5.0mm_P2.50mm
C23, C24, C25, C26, C27, C28, C29, C30, C31, C32, C33, C34, C35, C36, C37: C_Small; C_Disc_SMD
D1, D2: 1N4148; D_DO-35_SOD27_P7.62mm_Horizontal
D3, D6: 1N4744A; D_DO-41_SOD81_P7.62mm_Horizontal
D4, D5: 1N4004; D_DO-41_SOD81_P7.62mm_Horizontal
D7, D8: LED; LED_D3.0mm
J1, J3: Conn_Coaxial; bnc_90_1-1337543-0
J2, J4, J5: Conn_01x02; TerminalBlock_bornier-2_P5.08mm
J6, J7, J8, J9, J10, J11, J12, J13, J14, J15, J16, J17, J18, J19, J20, J21, J22, J23, J24, J25, J26, J27, J28, J29, J30, J31: Conn_01x01; 1pin
JP1, JP4, JP5, JP6: Jumper_NC_Dual; Pin_Header_Straight_1x03_Pitch2.54mm
JP2, JP3, JP7, JP8, JP9: Jumper_NC_Small; Pin_Header_Straight_1x02_Pitch2.54mm
L1, L2, L3: L; L_Axial_L6.6mm_D2.7mm_P10.16mm_Horizontal_Vishay_IM-2
L4, L5, L6, L7, L8, L9, L10, L11, L12, L13: L_Small; L_Toroid_Vertical_L13.0mm_W6.5mm_P5.60mm
Q1: 2N3904; TO-92_Molded_Narrow
Q2, Q3: IRF510N; TO-220-3_Vertical_WithPads
Q4, Q6: 2N3906; TO-92_Molded_Narrow
Q5: TIP42; TO-220-3_Vertical_WithPads
R1: 1k; R_Axial_DIN0207_L6.3mm_D2.5mm_P7.62mm_Horizontal
R2: 4k7; R_Axial_DIN0207_L6.3mm_D2.5mm_P7.62mm_Horizontal
R3, R5: 130R; R_Axial_DIN0411_L9.9mm_D3.6mm_P12.70mm_Horizontal
R4: 39R; R_Axial_DIN0411_L9.9mm_D3.6mm_P12.70mm_Horizontal
R6, R7: 4R7; R_Axial_DIN0207_L6.3mm_D2.5mm_P10.16mm_Horizontal
R8, R10: NC; R_Axial_DIN0207_L6.3mm_D2.5mm_P10.16mm_Horizontal
R9, R11: 27R; R_Axial_DIN0207_L6.3mm_D2.5mm_P10.16mm_Horizontal
R12, R15, R17: 10k; R_Axial_DIN0207_L6.3mm_D2.5mm_P7.62mm_Horizontal
R13: 2k4; R_Axial_DIN0411_L9.9mm_D3.6mm_P12.70mm_Horizontal
R14: 0R2; R_Axial_DIN0411_L9.9mm_D3.6mm_P12.70mm_Horizontal
R16, R21, R22: 470R; R_Axial_DIN0207_L6.3mm_D2.5mm_P7.62mm_Horizontal
R18, R19: 0R; R_Axial_DIN0207_L6.3mm_D2.5mm_P7.62mm_Horizontal
R20: 100k; R_Axial_DIN0207_L6.3mm_D2.5mm_P7.62mm_Horizontal
RLY1: DPDTRelay; G2VRelay
RV1, RV2: 10k; Potentiometer_Trimmer_Bourns_3296W
T1, T2: Transformer_1P1Sdotted; GenericCMCL2
T3: Transformer_1P1Sdotted; GenericCMCLCP

Connections:
+5V: C7.2, C8.2, C22.1, D6.1, R13.1, R17.1, RV1.1, RV2.1
+28V: C38.1, D3.1, D5.1, J4.1, JP4.1, JP8.1, Q4.1, Q5.3, Q6.1, R14.2
AMPINPUT: JP1.3, R3.1, R4.2, RLY1.8
AMPOUTPUT: JP5.1, JP6.1
BIASSUPPLY: D8.2, JP4.2
FILTERIN: J12.1, JP6.3
FILTEROUT: J13.1, JP5.3
GND: C3.2, C7.1, C8.1, C9.2, C10.2, C13.1, C14.1, C15.2, C16.2, C17.2, C18.2, C19.2, C22.2, C23.2, C24.2, C25.2, C26.2, C27.2, C28.2, C29.2, C30.2, C31.2, C32.2, C33.2, C34.2, C35.2, C36.2, C37.2, C38.2, D1.2, D5.2, D6.2, D7.1, J1.2, J2.2, J3.2, J4.2, J5.2, J6.1, J7.1, J8.1, J9.1, J22.1, J23.1, J24.1, J25.1, J26.1, J28.1, J29.1, J30.1, JP2.2, JP3.2, JP7.2, Q1.1, Q2.3, Q3.3, R2.2, R3.2, R5.2, R17.2, R20.2, RV1.3, RV2.3, T1.1, T3.3
unnamed: C1.1, J1.1, J2.1, RLY1.6
unnamed: C1.2, R1.1
unnamed: C2.1, C4.1, JP7.1, Q1.3, R18.1
unnamed: C2.2, C3.1, C4.2, JP9.1, Q1.2, R16.1, R20.1, R21.2
unnamed: C5.1, R6.1
unnamed: C5.2, T1.4
unnamed: C6.1, T1.2
unnamed: C6.2, R7.1
unnamed: C9.1, JP2.1, R9.2, RV1.2
unnamed: C10.1, JP3.1, R11.2, RV2.2
unnamed: C11.1, C13.2, C20.1, C21.1, Q2.2, T2.4, T3.2
unnamed: C11.2, R8.1
unnamed: C12.1, C14.2, C20.2, C21.2, Q3.2, T2.1, T3.1
unnamed: C12.2, R10.1
unnamed: C23.1, J10.1, L4.1
unnamed: C24.1, L4.2, L5.1
unnamed: C25.1, J11.1, L5.2
unnamed: C26.1, J14.1, L6.1
unnamed: C27.1, J15.1, L7.1
unnamed: C28.1, L6.2, L8.1
unnamed: C29.1, L7.2, L9.1
unnamed: C30.1, J16.1, L8.2
unnamed: C31.1, J17.1, L9.2
unnamed: C32.1, J18.1, L10.1
unnamed: C33.1, J19.1, L11.1
unnamed: C34.1, L10.2, L12.1
unnamed: C35.1, L11.2, L13.1
unnamed: C36.1, J20.1, L12.2
unnamed: C37.1, J21.1, L13.2
unnamed: D1.1, D2.2, R1.2, R2.1
unnamed: D2.1, JP9.2
unnamed: D3.2, JP8.2, R19.1
unnamed: D4.1, R19.2, RLY1.5
unnamed: D4.2, R18.2, RLY1.1
unnamed: D7.2, R15.2
unnamed: D8.1, R13.2
unnamed: J3.1, J5.1, RLY1.2
unnamed: J27.1, R16.2
unnamed: J31.1, R22.1
unnamed: JP1.1, R4.1, R5.1
unnamed: JP1.2, L1.1
unnamed: JP4.3, Q4.3
unnamed: JP5.2, RLY1.4
unnamed: JP6.2, T3.4
unnamed: L1.2, T1.3
unnamed: L2.1, Q2.1, R6.2, R8.2
unnamed: L2.2, R9.1
unnamed: L3.1, Q3.1, R7.2, R10.2
unnamed: L3.2, R11.1
unnamed: Q4.2, R12.2
unnamed: Q5.2, R12.1, R15.1
unnamed: Q6.2, R22.2
unnamed: Q6.3, R21.1
unnamed: RLY1.3, RLY1.7
PASUPPLY: C15.1, C16.1, C17.1, C18.1, C19.1, Q5.1, R14.1, T2.2, T2.3
