profdc9/QRPAmplifier/(commit log)

2019-02-13 Made filter capacitors mica or 1206 SMT
    [Filters.sch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]
2019-02-13 Add transmit disable switch
    [Filters.sch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]
2019-02-14 Artwork fix
    [PA-B.Cu.gbr, PA-B.Mask.gbr, PA-B.SilkS.gbr, PA-Edge.Cuts.gbr, PA-F.Cu.gbr, PA-F.Mask.gbr, PA-F.SilkS.gbr, PA-NPTH.drl]
2019-02-14 Tightened up components
    [Filters.sch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]
2019-02-14 Last commit has wrong PCB screenshot
    [PA-B.Cu.gbr, PA-B.Mask.gbr, PA-B.SilkS.gbr, PA-Edge.Cuts.gbr, PA-F.Cu.gbr, PA-F.Mask.gbr, PA-F.SilkS.gbr, PA-NPTH.drl]
2019-02-14 Delete PA-board.png
    Problem with committing this !
2019-02-15 Some more comitization
    [Filters.sch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]
2019-02-16 Moved T!
    [PA-B.Cu.gbr, PA-B.Mask.gbr, PA-B.SilkS.gbr, PA-Edge.Cuts.gbr, PA-F.Cu.gbr, PA-F.Mask.gbr, PA-F.SilkS.gbr, PA-NPTH.drl]
2019-02-20 Changed overcurrent circuit...
    [Filters.sch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]
2019-02-21 Added via fences
    [PA-B.Cu.gbr, PA-B.Mask.gbr, PA-B.SilkS.gbr, PA-Edge.Cuts.gbr, PA-F.Cu.gbr, PA-F.Mask.gbr, PA-F.SilkS.gbr, PA-NPTH.drl]
2019-06-01 Added more convenient pads for TO220 devices
    [Filters.sch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]
2019-06-08 JLCPCB order tested
    [Filters.sch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]
2019-06-28 Added BiggerPA
    [Filters.sch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]
2019-06-28 Added series inductor to gates
    [PA-B.Cu.gbr, PA-B.Mask.gbr, PA-B.SilkS.gbr, PA-Edge.Cuts.gbr, PA-F.Cu.gbr, PA-F.Mask.gbr, PA-F.SilkS.gbr, PA-NPTH.drl]
2019-06-30 Added Filter
    [Filter-B.Cu.gbr, Filter-B.Mask.gbr, Filter-B.SilkS.gbr, Filter-Edge.Cuts.gbr, Filter-F.Cu.gbr, Filter-F.Mask.gbr, Filter-F.SilkS.gbr, Filter-NPTH.drl]
2019-07-03 Changed to 7805 regulator
    [PA-B.Cu.gbr, PA-B.Mask.gbr, PA-B.SilkS.gbr, PA-Edge.Cuts.gbr, PA-F.Cu.gbr, PA-F.Mask.gbr, PA-F.SilkS.gbr, PA-NPTH.drl]
2019-07-12 Added some extra protection and fixed labels on Filter
    [Filter-B.Cu.gbr, Filter-B.Mask.gbr, Filter-B.SilkS.gbr, Filter-Edge.Cuts.gbr, Filter-F.Cu.gbr, Filter-F.Mask.gbr, Filter-F.SilkS.gbr, Filter-NPTH.drl]
2019-07-20 Added gate resistors to BiggerPA
    [PA-B.Cu.gbr, PA-B.Mask.gbr, PA-B.SilkS.gbr, PA-Edge.Cuts.gbr, PA-F.Cu.gbr, PA-F.Mask.gbr, PA-F.SilkS.gbr, PA-NPTH.drl]
2019-10-01 Changed rig RX/TX control
    [PA-B.Cu.gbr, PA-B.Mask.gbr, PA-B.SilkS.gbr, PA-Edge.Cuts.gbr, PA-F.Cu.gbr, PA-F.Mask.gbr, PA-F.SilkS.gbr, PA-NPTH.drl]
2019-10-20 Fixed polarity of rig RXTX relay grounding
    [Filters.sch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]
2019-11-13 Added tandem match to sense power to filter board
    [Filter-B.Cu.gbr, Filter-B.Mask.gbr, Filter-B.SilkS.gbr, Filter-Edge.Cuts.gbr, Filter-F.Cu.gbr, Filter-F.Mask.gbr, Filter-F.SilkS.gbr, Filter-NPTH.drl]
2020-04-29 Moved series resistor closer to common drain amplifier to prevent oscillation
    [Filter-B.Cu.gbr, Filter-B.Mask.gbr, Filter-B.SilkS.gbr, Filter-Edge.Cuts.gbr, Filter-F.Cu.gbr, Filter-F.Mask.gbr, Filter-F.SilkS.gbr, Filter-NPTH.drl]
