profdc9/QRPAmplifier/(notices)

Notices in the files:
Filter/Filter.kicad_pcb:
KW4TI CC-BY-SA 4.0
BiggerPA/PA.kicad_pcb:
BY KW4TI CC-BY-SA 4.0
PA/PA.sch:
WA2EBY amplifier, in KiCAD by KW4TI, CC-BY-SA 4.0
